0xJeremy/Daedalus/README.md

# Daedalus Motor Controller

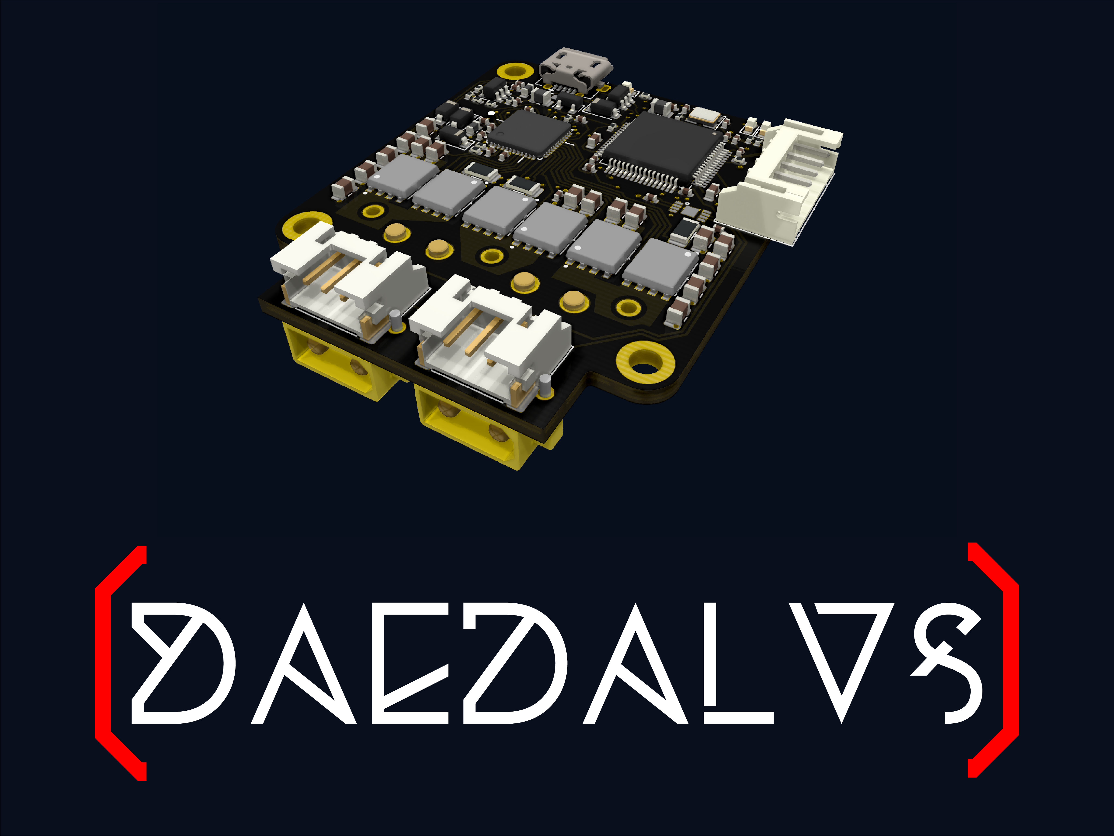
[picture p1: docs/logo/Daedalus_Brackets_Board.png]


### Board Layout
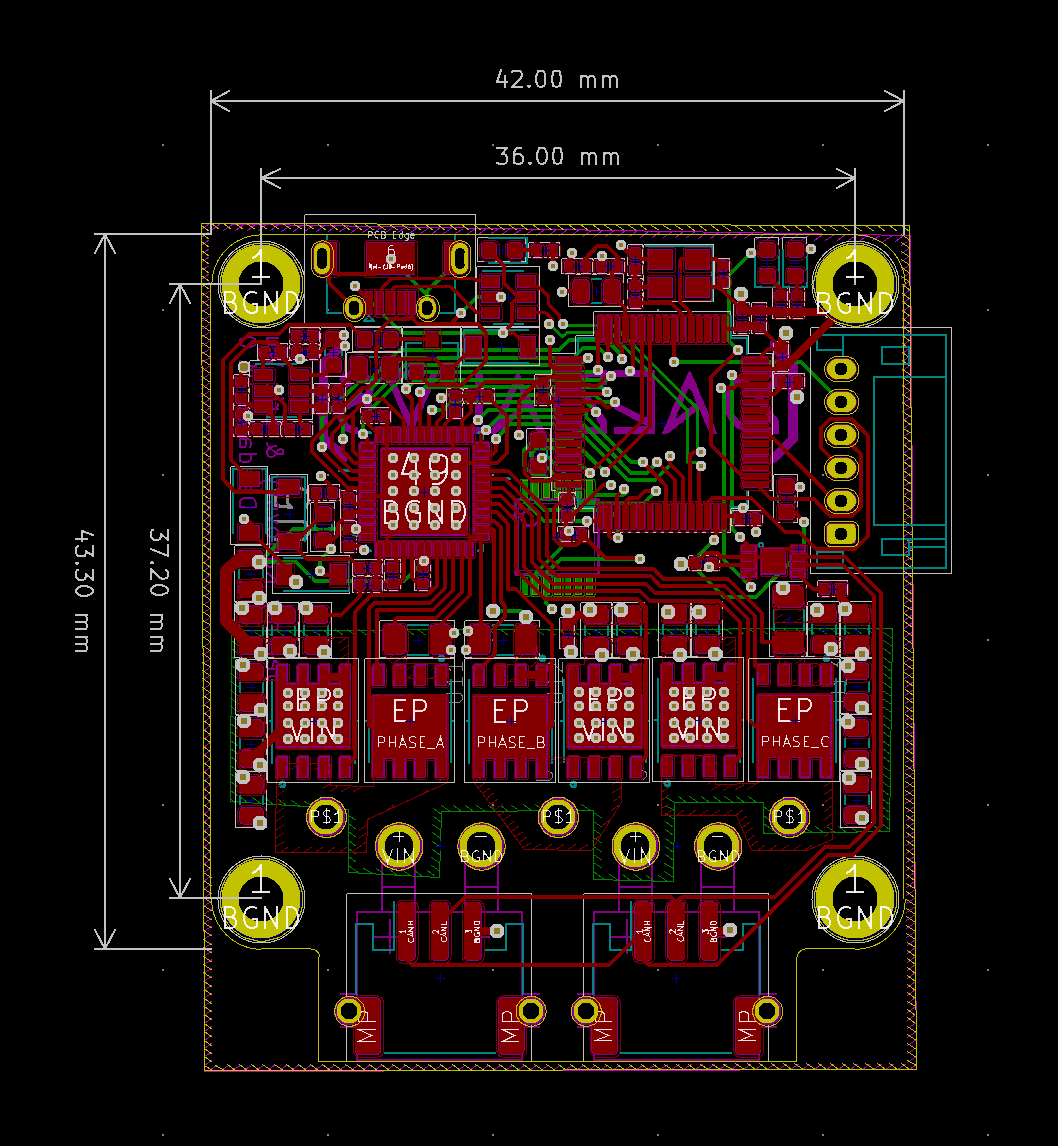
[picture p2: docs/Board_Layout.png]
Board Layout
