0xJeremy/Daedalus/docs/Back.jpg

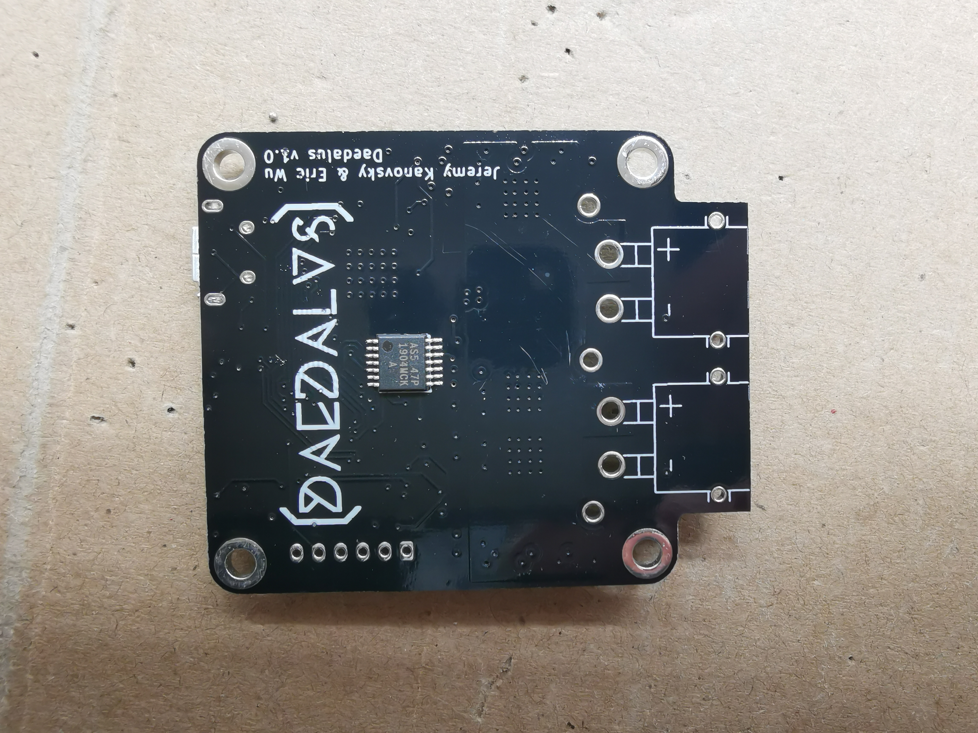
docs/Back.jpg
