0xJeremy/Daedalus/docs/renders/back.png

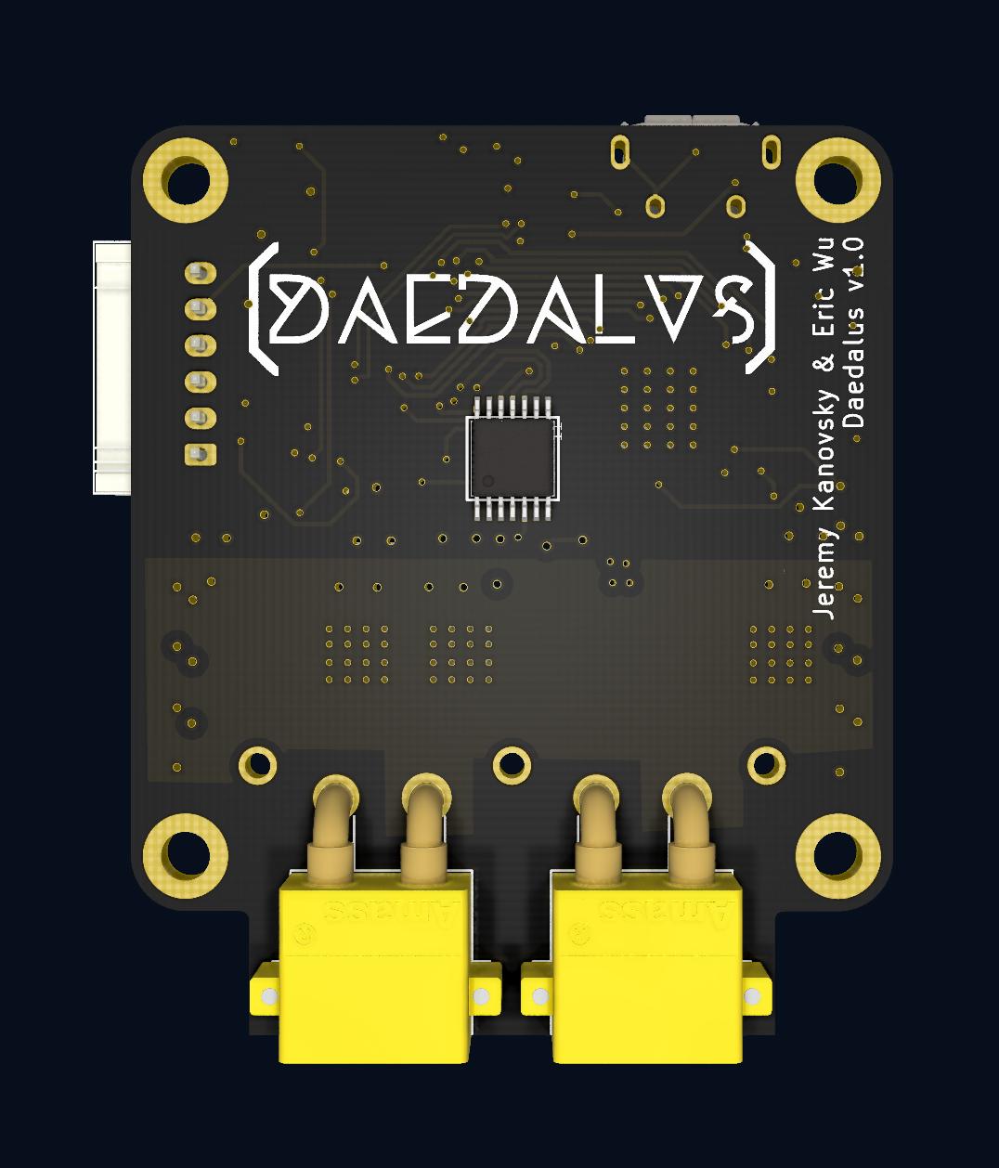
docs/renders/back.png
