0xJeremy/Daedalus/docs/renders/front.png

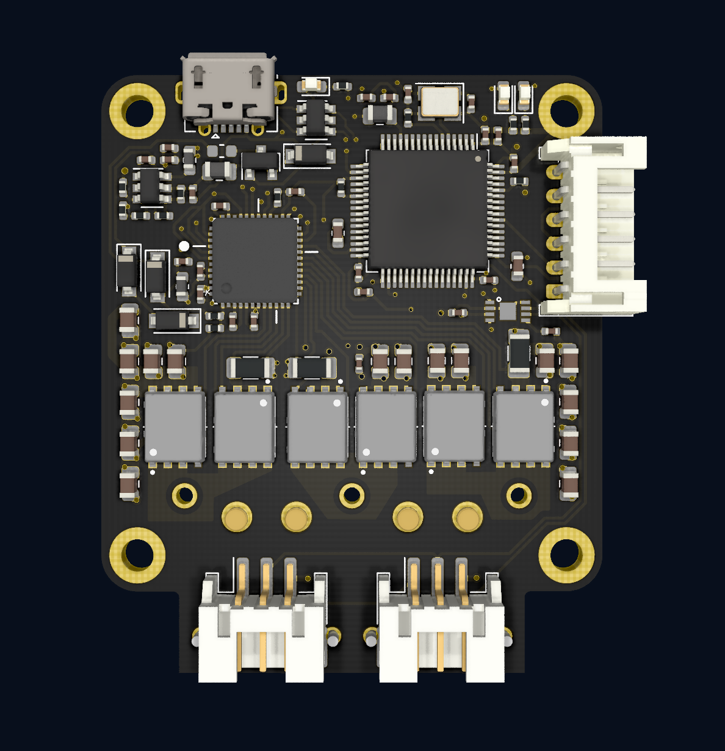
docs/renders/front.png
