0xJeremy/Daedalus/docs/renders/isometric.png

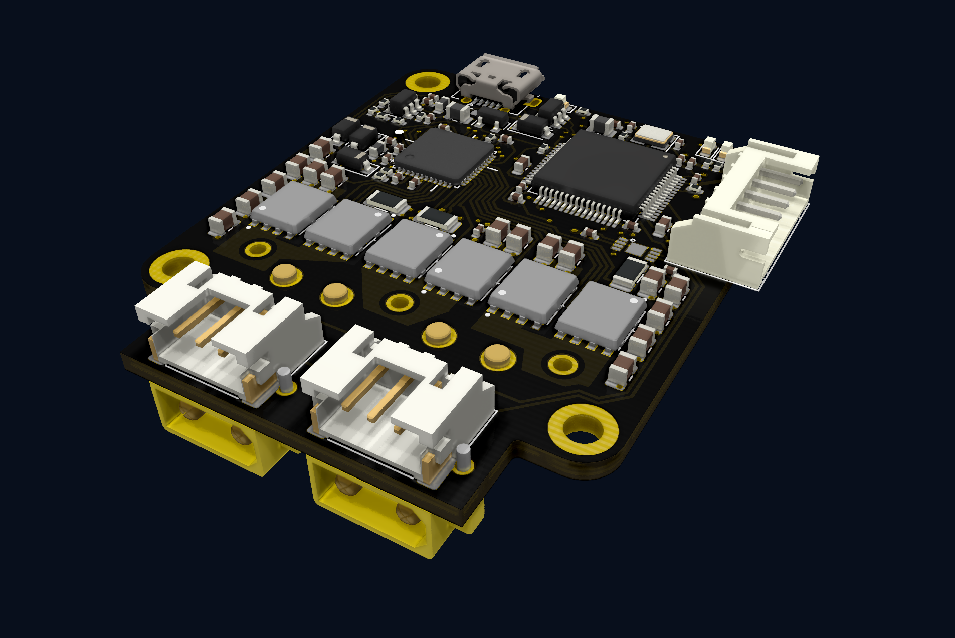
docs/renders/isometric.png
