0xJeremy/Daedalus/docs/renders/side.png

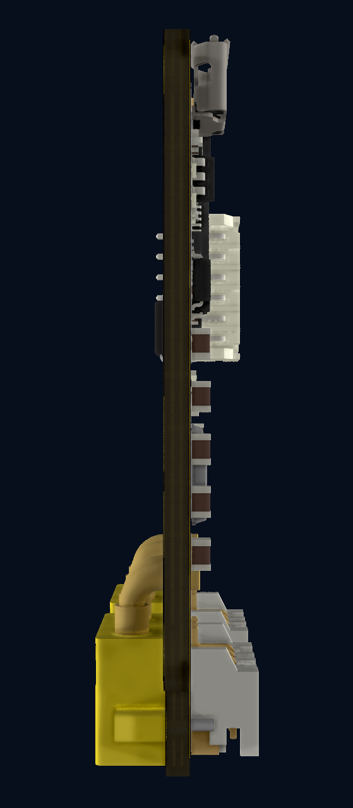
docs/renders/side.png
