0xJeremy/Daedalus/docs/logo/Daedalus Silkscreen.dxf

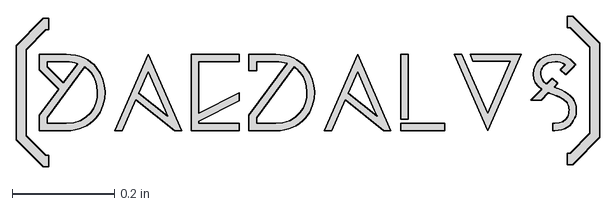
[picture p8: CAD file, 2021-03-04]
docs/logo/Daedalus Silkscreen.dxf
1.14 x 0.294 in
