0xJeremy/Daedalus/docs/Test Stand/Stand.SLDPRT

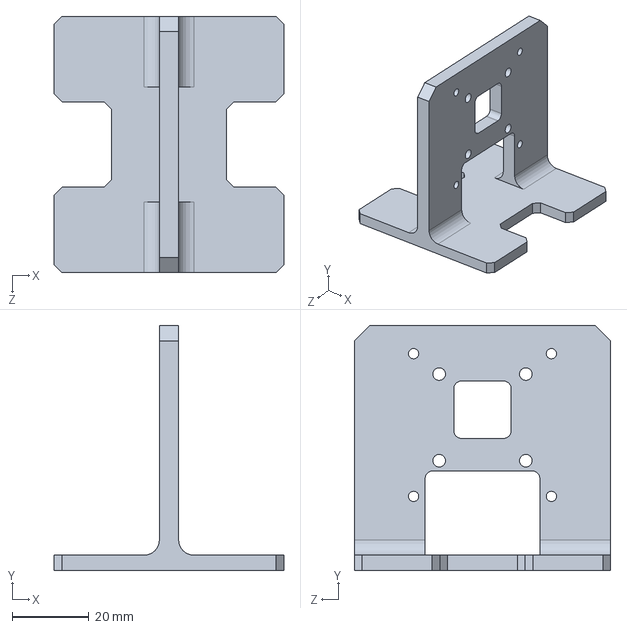
[picture p9: CAD file, 2021-06-15]
docs/Test Stand/Stand.SLDPRT
60.0 x 64.0 x 67.0 mm
