0xJeremy/Daedalus/kicad/daedalus_kicad_lib/STEP/molex_0473460001.STEP

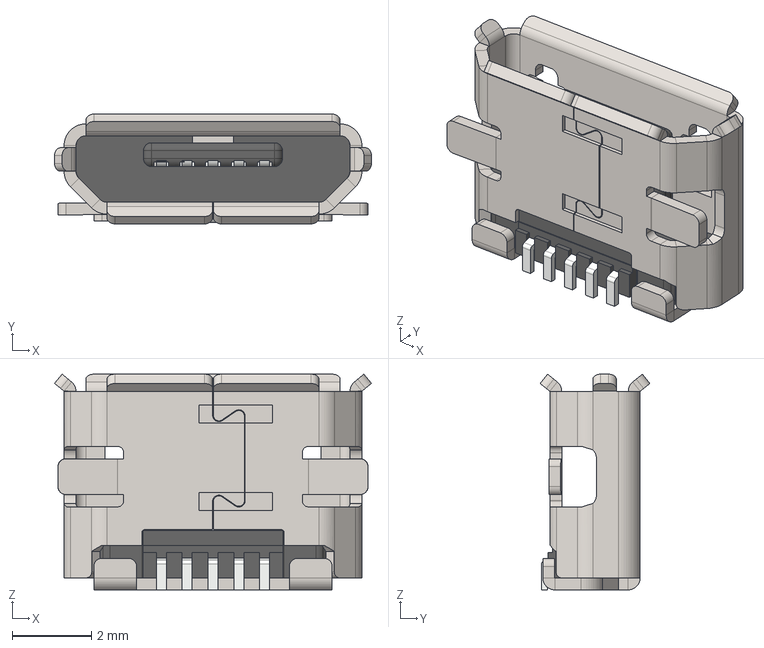
[picture p10: CAD file, 2021-03-02]
kicad/daedalus_kicad_lib/STEP/molex_0473460001.STEP
7.98 x 2.76 x 5.43 mm
