0xJeremy/Daedalus/kicad/daedalus_kicad_lib/STEP/QFN127P600-8N.step

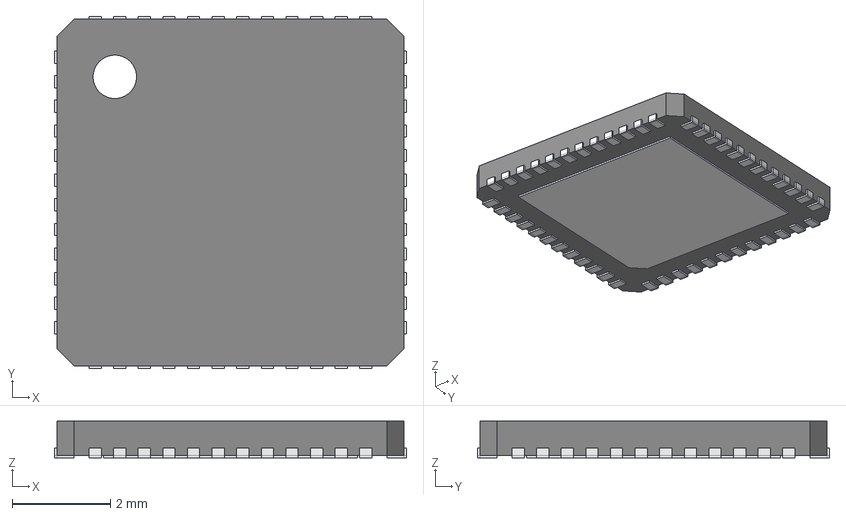
[picture p11: CAD file, 2021-03-02]
kicad/daedalus_kicad_lib/STEP/QFN127P600-8N.step
7.15 x 7.15 x 0.75 mm
Open_CASCADE_STEP_translator_6.8_1.1
Open_CASCADE_STEP_translator_6.8_1.2.1
Thermal_Shape
Open_CASCADE_STEP_translator_6.8_1.4.1 x 48
