0xJeremy/Daedalus/kicad/daedalus_kicad_lib/STEP/TSSOP-14.stp

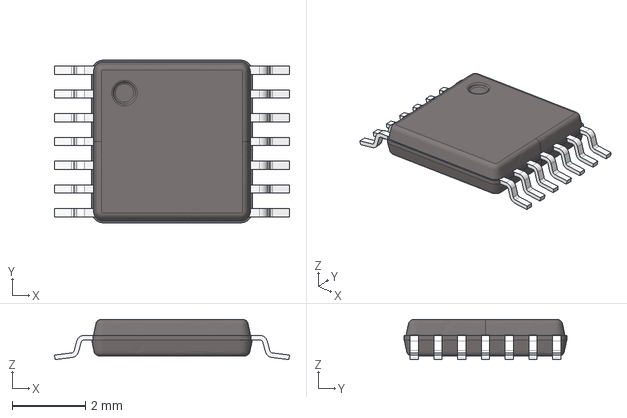
[picture p12: CAD file, 2021-03-02]
kicad/daedalus_kicad_lib/STEP/TSSOP-14.stp
6.43 x 4.45 x 1.10 mm
