0xJeremy/Daedalus/kicad/daedalus_kicad_lib/STEP/Amass_XT30PW-M_pcb solder.stp

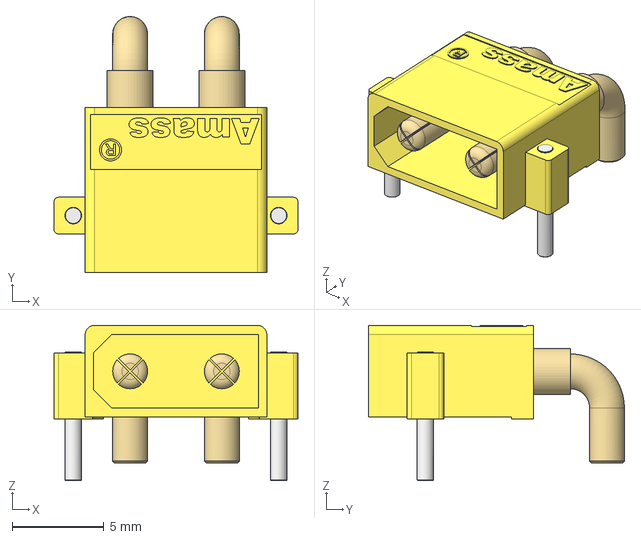
[picture p13: CAD file, 2021-03-02]
kicad/daedalus_kicad_lib/STEP/Amass_XT30PW-M_pcb solder.stp
13.3 x 13.9 x 8.45 mm
