0xJeremy/Daedalus/kicad/daedalus_kicad_lib/STEP/PowerFLAT 5x6.STEP

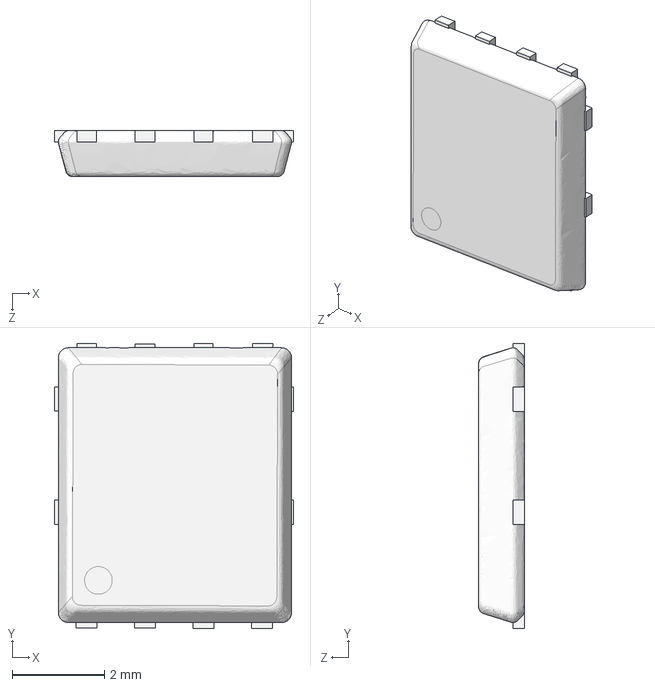
[picture p14: CAD file, 2021-03-02]
kicad/daedalus_kicad_lib/STEP/PowerFLAT 5x6.STEP
5.19 x 6.18 x 1.00 mm
