0xJeremy/Daedalus/kicad/daedalus_kicad_lib/STEP/S3B-PH-SM4-TB.stp

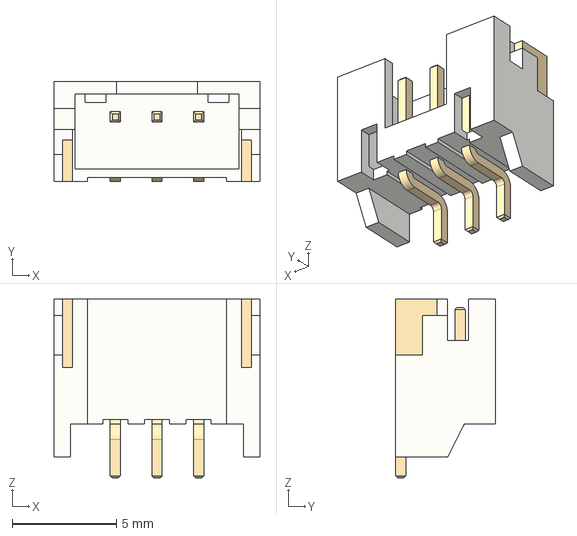
[picture p15: CAD file, 2021-03-02]
kicad/daedalus_kicad_lib/STEP/S3B-PH-SM4-TB.stp
9.90 x 4.80 x 8.60 mm
