0xJeremy/Daedalus/(list of files, cad)

Other CAD files:
docs/Test Stand/exports/Stand.STL
kicad/daedalus_kicad_lib/STEP/PowerFLAT 5x6.stp
