0xJeremy/Daedalus/docs/Test Stand/dependencies/Antigravity 6007 T-Motor/6007_bottom.JPG

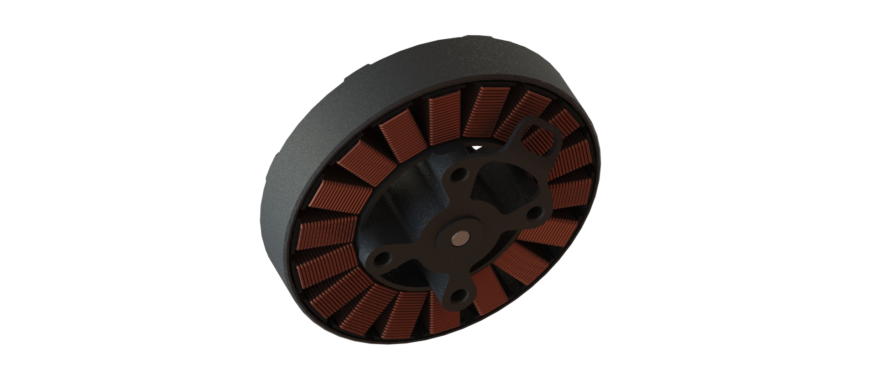
docs/Test Stand/dependencies/Antigravity 6007 T-Motor/6007_bottom.JPG
