0xJeremy/Daedalus/docs/daedalus.pdf

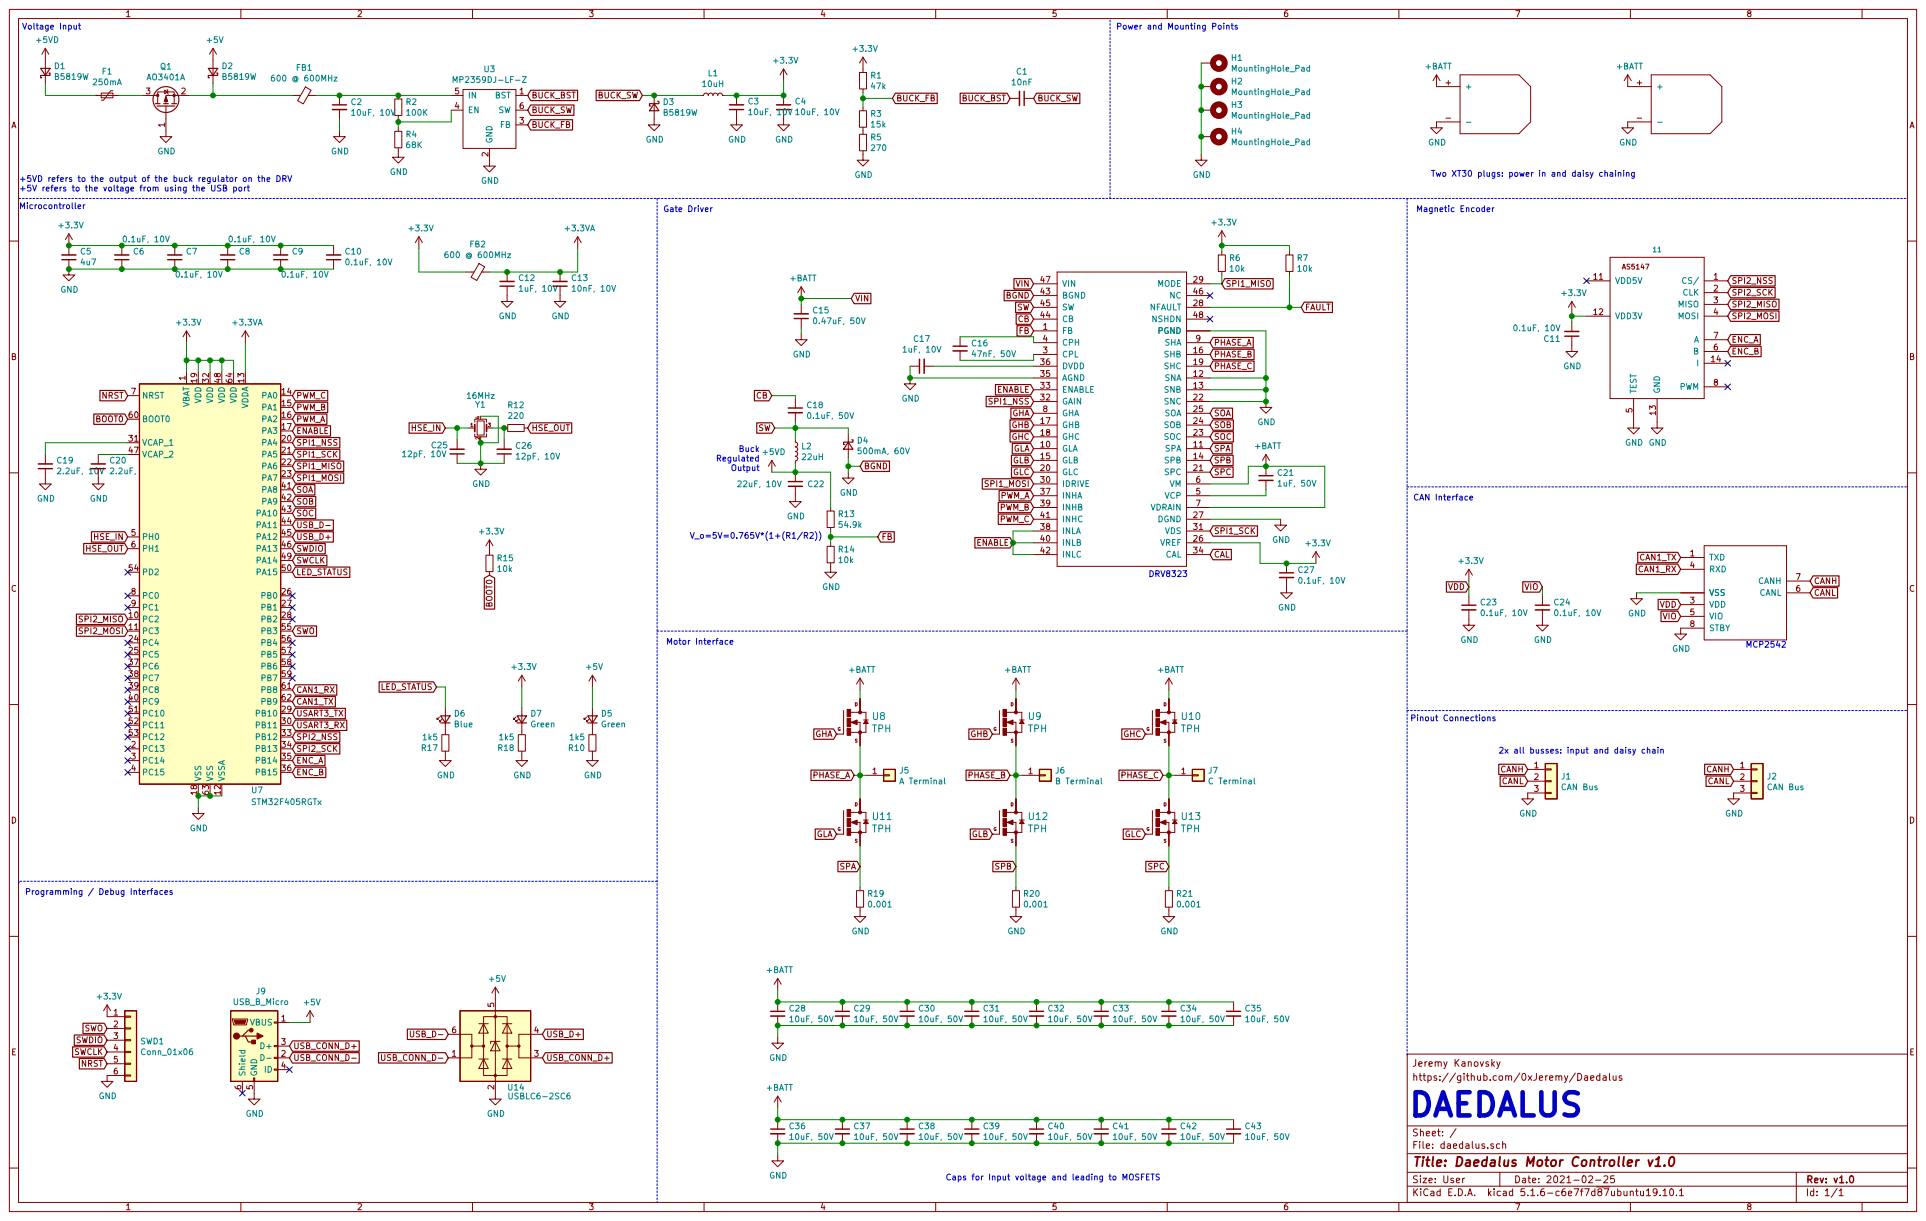
[picture p18: page 1]

Power and Mounting Points Buck Regulated

BUCK_SW
Two XT30 plugs: power in and daisy chaining Pinout Connections

+5VD refers to the output of the buck regulator on the DRV
+5V refers to the voltage from using the USB port

1 VCAP_1 31 VCAP_2 47 VDD 19 VDD 32 VDD 48 VDD 64 VDDA 13 VSS 18 VSS 63 VSSA 12U7STM32F405RGTx

2x all busses: input and daisy chain

Jeremy Kanovsky
File: daedalus.sch Sheet: / https://github.com/0xJeremy/Daedalus
DAEDALUS

Id: 1/1 Title: Daedalus Motor Controller v1.0

Caps for Input voltage and leading to MOSFETS
