0xJeremy/Daedalus/kicad/daedalus.kicad_pcb

## KiCad design kicad/daedalus.kicad_pcb (2021-03-08)

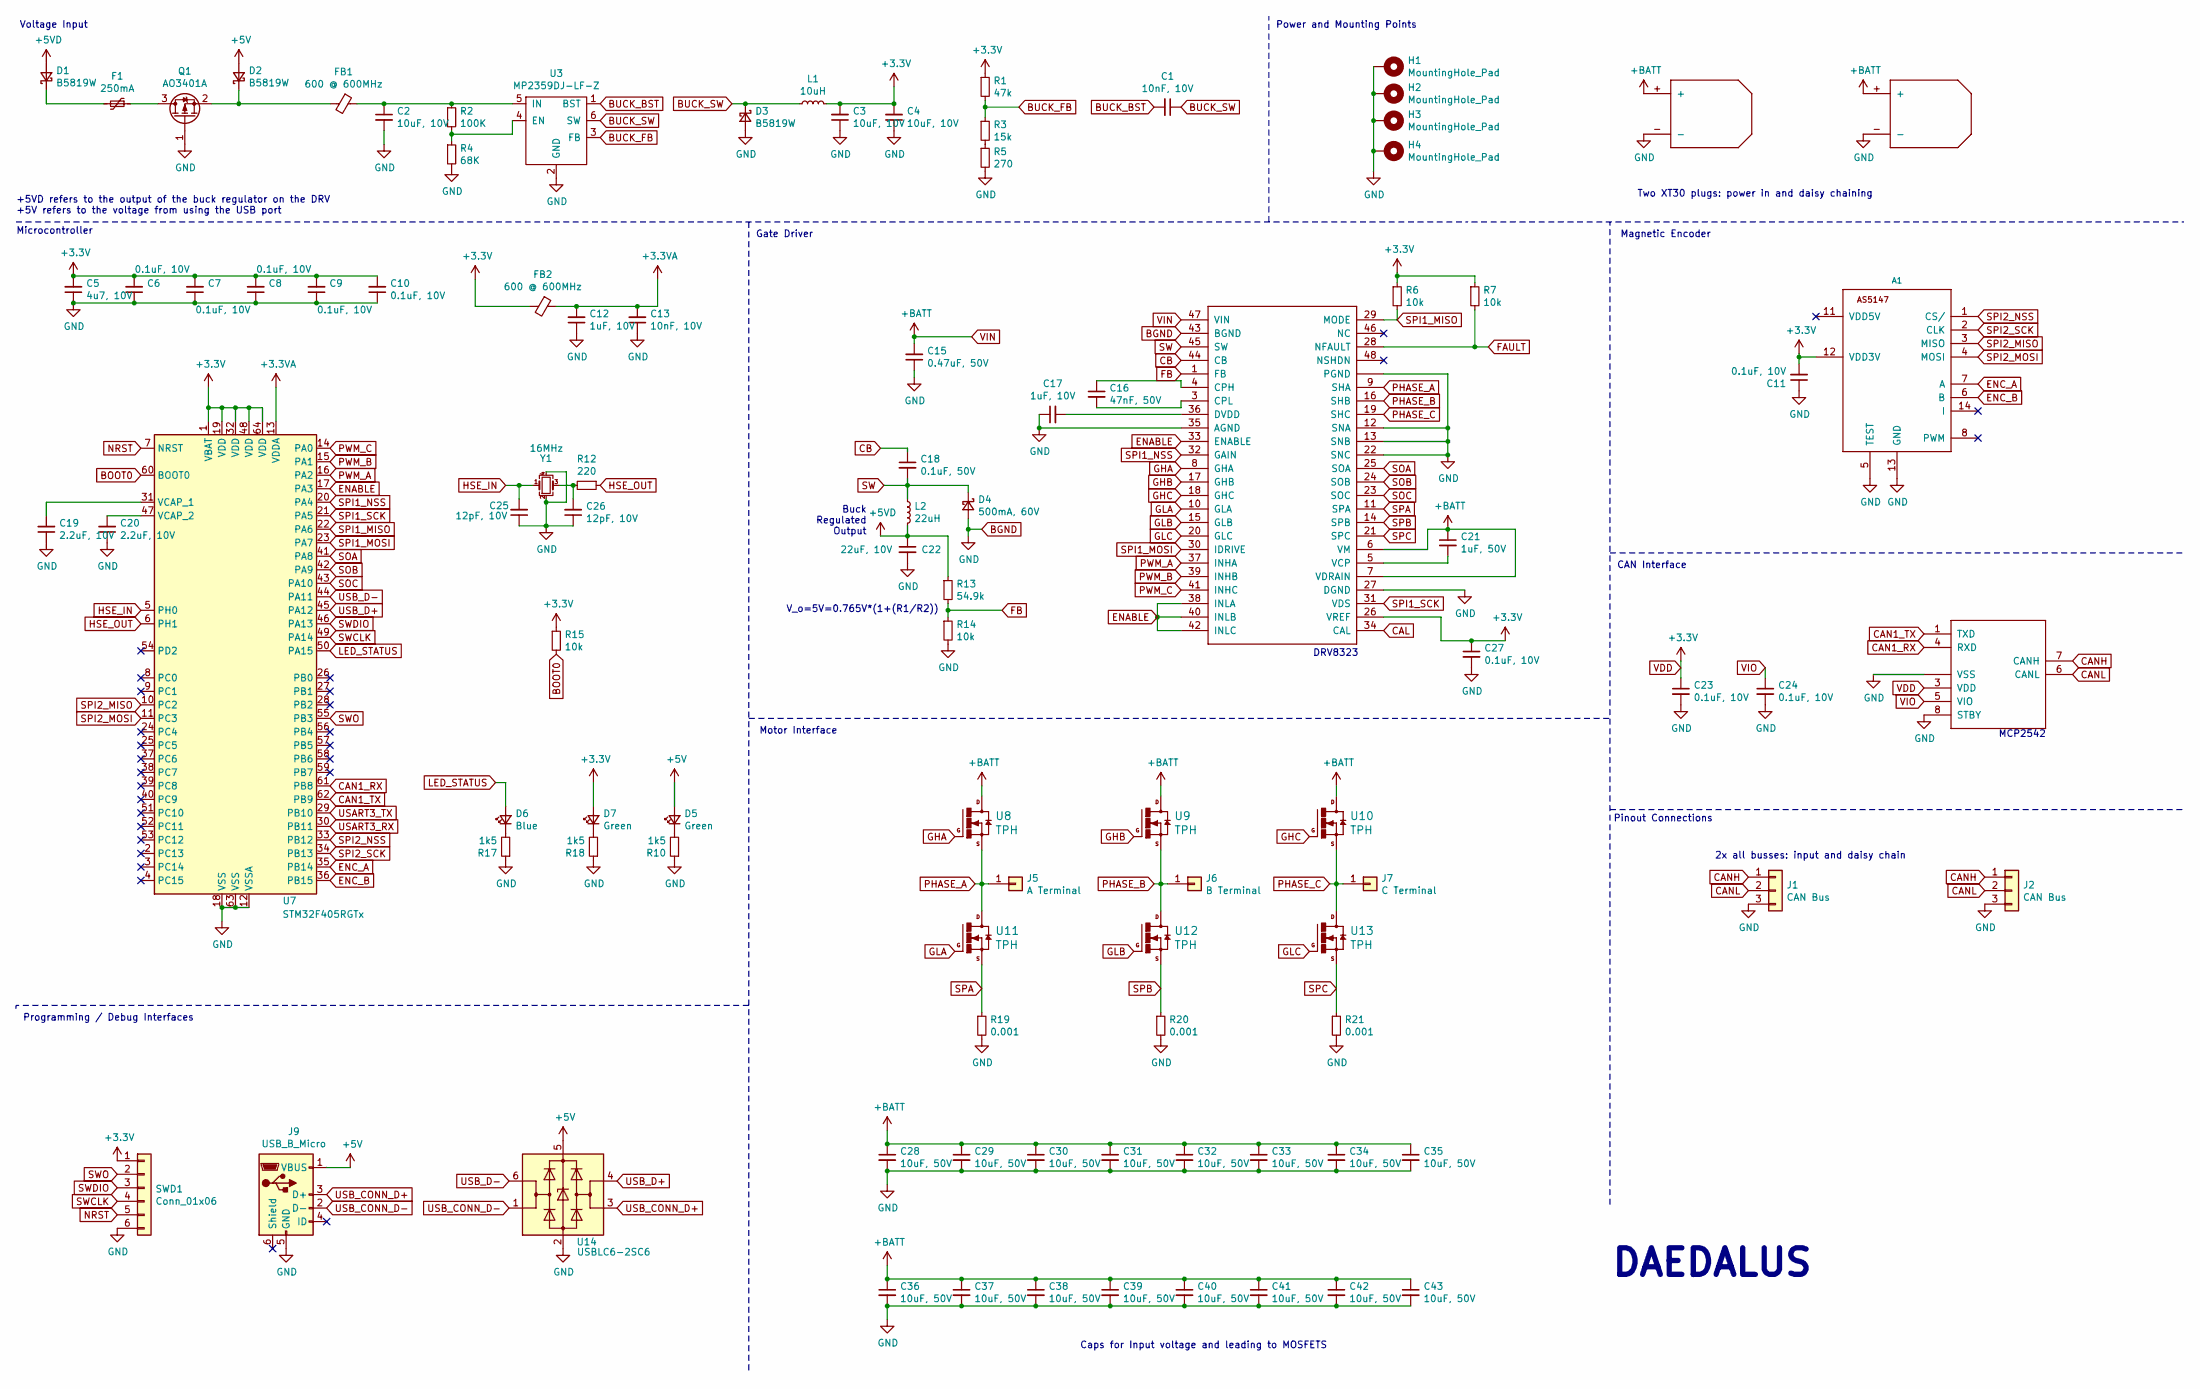
[picture p19: schematic daedalus.sch, Daedalus Motor Controller v1.0]

Parts:
A1: AS5147; TSSOP14_as5147
C1: 10nF, 10V; C_0402_1005Metric
C2, C3, C4: 10uF, 10V; C_0402_1005Metric
C5: 4u7, 10V; C_0402_1005Metric; LCSC Part # C23733
C6, C7, C8, C9, C10: 0.1uF, 10V; C_0402_1005Metric; LCSC Part # C1525
C11, C23, C24, C27: 0.1uF, 10V; C_0402_1005Metric
C12: 1uF, 10V; C_0402_1005Metric; LCSC Part # C1525
C13: 10nF, 10V; C_0402_1005Metric; LCSC Part # C1523
C15: 0.47uF, 50V; C_0402_1005Metric
C16: 47nF, 50V; C_0402_1005Metric
C17: 1uF, 10V; C_0402_1005Metric
C18: 0.1uF, 50V; C_0402_1005Metric
C19, C20: 2.2uF, 10V; C_0603_1608Metric; LCSC Part # C23630
C21: 1uF, 50V; C_0402_1005Metric
C22: 22uF, 10V; C_0402_1005Metric
C25, C26: 12pF, 10V; C_0402_1005Metric; LCSC Part # C1547
C28, C29, C30, C31, C32, C33, C34, C35, C36, C37, C38, C39, C40, C41, C42, C43: 10uF, 50V; C_0805_2012Metric
D1, D2, D3: B5819W; D_SOD-123
D4: 500mA, 60V; D_SOD-123
D5, D7: Green; LED_0603_1608Metric; LCSC Part # C2286
D6: Blue; LED_0603_1608Metric; LCSC Part # C2286
F1: 250mA; Fuse_0603_1608Metric
FB1: 600 @ 600MHz; L_0805_2012Metric
FB2: 600 @ 600MHz; L_0805_2012Metric; LCSC Part # C1015
H1, H2, H3, H4: MountingHole_Pad; MountingHole_2.7mm_M2.5_DIN965_Pad
J1, J2: CAN Bus; JST_PH_S3B-PH-SM4-TB_1x03-1MP_P2.00mm_Horizontal
J5: A Terminal; 18_AWG_PAD
J6: B Terminal; 18_AWG_PAD
J7: C Terminal; 18_AWG_PAD
J9: USB_B_Micro; USB_Micro-AB_Molex_47590-0001
L1: 10uH; L_0603_1608Metric
L2: 22uH; L_0603_1608Metric
Q1: AO3401A; SOT-23
R1: 47k; R_0402_1005Metric
R2: 100K; R_0402_1005Metric
R3: 15k; R_0402_1005Metric
R4: 68K; R_0402_1005Metric
R5: 270; R_0402_1005Metric
R6, R7, R14: 10k; R_0402_1005Metric
R10, R17, R18: 1k5; R_0402_1005Metric; LCSC Part # C25867
R12: 220; R_0402_1005Metric; LCSC Part # C22962
R13: 54.9k; R_0402_1005Metric
R15: 10k; R_0402_1005Metric; LCSC Part # C25744
R19, R20, R21: 0.001; R_1206_3216Metric
SWD1: Conn_01x06; JST_PH_S6B-PH-K_1x06_P2.00mm_Horizontal
U1, U2: XT30; XT30_HORIZONTAL
U3: MP2359DJ-LF-Z; SOT-23-6
U5: DRV8323RH; QFN50P700X700X90-49N
U6: MCP2542; TDFN
U7: STM32F405RGTx; LQFP-64_10x10mm_P0.5mm; LCSC Part # C15742
U8, U9, U10, U11, U12, U13: TPH; TRANS_TPH5900CNH,L1Q
U14: USBLC6-2SC6; SOT-23-6
Y1: 16MHz; Crystal_SMD_3225-4Pin_3.2x2.5mm; LCSC Part # C13738

Connections:
+3.3VA: C12.2, C13.2, FB2.1, U7.13 (VDDA)
+5V: D2.2 (A), D5.2 (A), J9.1 (VBUS), U14.5 (VBUS)
+5VD: C22.1, D1.2 (A), L2.2, R13.1
BGND: A1.5 (TEST), A1.13 (GND), C2.2, C3.1, C4.1, C5.1, C6.1, C7.1, C8.1, C9.1, C10.1, C11.1, C12.1, C13.1, C15.1, C17.1, C19.1, C20.1, C22.2, C23.2, C24.2, C25.1, C26.1, C27.2, C28.2, C29.2, C30.2, C31.2, C32.2, C33.2, C34.2, C35.2, C36.2, C37.2, C38.2, C39.2, C40.2, C41.2, C42.2, C43.2, D3.2 (A), D4.2 (A), H1.1, H2.1, H3.1, H4.1, J1.3, J2.3, J9.5 (GND), Q1.1 (G), R4.2, R5.2, R10.1, R14.2, R17.1, R18.1, R19.2, R20.2, R21.2, SWD1.6, U1.-, U2.-, U3.2 (GND), U5.2 (PGND), U5.12 (SNA), U5.13 (SNB), U5.22 (SNC), U5.27 (DGND), U5.35 (AGND), U5.43 (BGND), U5.49 (PGND), U6.2 (VSS), U6.8 (STBY), U6.9 (VSS), U7.12 (VSSA), U7.18 (VSS), U7.63 (VSS), U14.2 (GND), Y1.2, Y1.4
BOOT0: R15.2, U7.60 (BOOT0)
BUCK_BST: C1.2, U3.1 (BST)
BUCK_FB: R1.2, R3.1, U3.3 (FB)
BUCK_SW: C1.1, D3.1 (K), L1.1, U3.6 (SW)
CAL: U5.34 (CAL)
CAN1_RX: U6.4 (RXD), U7.61 (PB8)
CAN1_TX: U6.1 (TXD), U7.62 (PB9)
CANH: J1.1, J2.1, U6.7 (CANH)
CANL: J1.2, J2.2, U6.6 (CANL)
CB: C18.1, U5.44 (CB)
ENABLE: U5.33 (ENABLE), U5.38 (INLA), U5.40 (INLB), U5.42 (INLC), U7.17 (PA3)
ENC_A: A1.7 (A), U7.35 (PB14)
ENC_B: A1.6 (B), U7.36 (PB15)
FAULT: R7.2, U5.28 (NFAULT)
FB: R13.2, R14.1, U5.1 (FB)
GHA: U5.8 (GHA), U8.4 (G)
GHB: U5.17 (GHB), U9.4 (G)
GHC: U5.18 (GHC), U10.4 (G)
GLA: U5.10 (GLA), U11.4 (G)
GLB: U5.15 (GLB), U12.4 (G)
GLC: U5.20 (GLC), U13.4 (G)
HSE_IN: C25.2, U7.5 (PH0), Y1.1
HSE_OUT: R12.1, U7.6 (PH1)
LED_STATUS: D6.2 (A), U7.50 (PA15)
NRST: SWD1.5, U7.7 (NRST)
unnamed: C2.1, FB1.1, R2.1, U3.5 (IN)
unnamed: C16.1, U5.4 (CPH)
unnamed: C16.2, U5.3 (CPL)
unnamed: C17.2, U5.36 (DVDD)
unnamed: C19.2, U7.31 (VCAP_1)
unnamed: C20.2, U7.47 (VCAP_2)
unnamed: C21.2, U5.5 (VCP)
unnamed: C26.2, R12.2, Y1.3
unnamed: D1.1 (K), F1.2
unnamed: D2.1 (K), FB1.2, Q1.2 (S)
unnamed: D5.1 (K), R10.2
unnamed: D6.1 (K), R17.2
unnamed: D7.1 (K), R18.2
unnamed: F1.1, Q1.3 (D)
unnamed: R2.2, R4.1, U3.4 (EN)
unnamed: R3.2, R5.1
PHASE_A: J5.1, U5.9 (SHA), U8.1 (S), U8.2 (S), U8.3 (S), U11.5 (D), U11.6 (D), U11.7 (D), U11.8 (D), U11.EP (D)
PHASE_B: J6.1, U5.16 (SHB), U9.1 (S), U9.2 (S), U9.3 (S), U12.5 (D), U12.6 (D), U12.7 (D), U12.8 (D), U12.EP (D)
PHASE_C: J7.1, U5.19 (SHC), U10.1 (S), U10.2 (S), U10.3 (S), U13.5 (D), U13.6 (D), U13.7 (D), U13.8 (D), U13.EP (D)
PWM_A: U5.37 (INHA), U7.16 (PA2)
PWM_B: U5.39 (INHB), U7.15 (PA1)
PWM_C: U5.41 (INHC), U7.14 (PA0)
SOA: U5.25 (SOA), U7.41 (PA8)
SOB: U5.24 (SOB), U7.42 (PA9)
SOC: U5.23 (SOC), U7.43 (PA10)
SPA: R19.1, U5.11 (SPA), U11.1 (S), U11.2 (S), U11.3 (S)
SPB: R20.1, U5.14 (SPB), U12.1 (S), U12.2 (S), U12.3 (S)
SPC: R21.1, U5.21 (SPC), U13.1 (S), U13.2 (S), U13.3 (S)
SPI1_MISO: R6.2, U5.29 (MODE), U7.22 (PA6)
SPI1_MOSI: U5.30 (IDRIVE), U7.23 (PA7)
SPI1_NSS: U5.32 (GAIN), U7.20 (PA4)
SPI1_SCK: U5.31 (VDS), U7.21 (PA5)
SPI2_MISO: A1.3 (MISO), U7.10 (PC2)
SPI2_MOSI: A1.4 (MOSI), U7.11 (PC3)
SPI2_NSS: A1.1 (CS/), U7.33 (PB12)
SPI2_SCK: A1.2 (CLK), U7.34 (PB13)
SW: C18.2, D4.1 (K), L2.1, U5.45 (SW)
SWCLK: SWD1.4, U7.49 (PA14)
SWDIO: SWD1.3, U7.46 (PA13)
SWO: SWD1.2, U7.55 (PB3)
USART3_RX: U7.30 (PB11)
USART3_TX: U7.29 (PB10)
USB_CONN_D+: J9.3 (D+), U14.3 (I/O2)
USB_CONN_D-: J9.2 (D-), U14.1 (I/O1)
USB_D+: U7.45 (PA12), U14.4 (I/O2)
USB_D-: U7.44 (PA11), U14.6 (I/O1)
VDD: A1.12 (VDD3V), C3.2, C4.2, C5.2, C6.2, C7.2, C8.2, C9.2, C10.2, C11.2, C23.1, C27.1, D7.2 (A), FB2.2, L1.2, R1.1, R6.1, R7.1, R15.1, SWD1.1, U5.26 (VREF), U6.3 (VDD), U7.1 (VBAT), U7.19 (VDD), U7.32 (VDD), U7.48 (VDD), U7.64 (VDD)
VIN: C15.2, C21.1, C28.1, C29.1, C30.1, C31.1, C32.1, C33.1, C34.1, C35.1, C36.1, C37.1, C38.1, C39.1, C40.1, C41.1, C42.1, C43.1, U1.+, U2.+, U5.6 (VM), U5.7 (VDRAIN), U5.47 (VIN), U8.5 (D), U8.6 (D), U8.7 (D), U8.8 (D), U8.EP (D), U9.5 (D), U9.6 (D), U9.7 (D), U9.8 (D), U9.EP (D), U10.5 (D), U10.6 (D), U10.7 (D), U10.8 (D), U10.EP (D)
VIO: C24.1, U6.5 (VIO)

Notes on the sheet:
Microcontroller
Voltage Input
Programming / Debug Interfaces
Power and Mounting Points
Gate Driver
Magnetic Encoder
DRV8323
Motor Interface
CAN Interface
MCP2542
Pinout Connections
V_o=5V=0.765V*(1+(R1/R2))
Buck Regulated Output
+5VD refers to the output of the buck regulator on the DRV +5V refers to the voltage from using the USB port
Two XT30 plugs: power in and daisy chaining
2x all busses: input and daisy chain
Caps for Input voltage and leading to MOSFETS
DAEDALUS

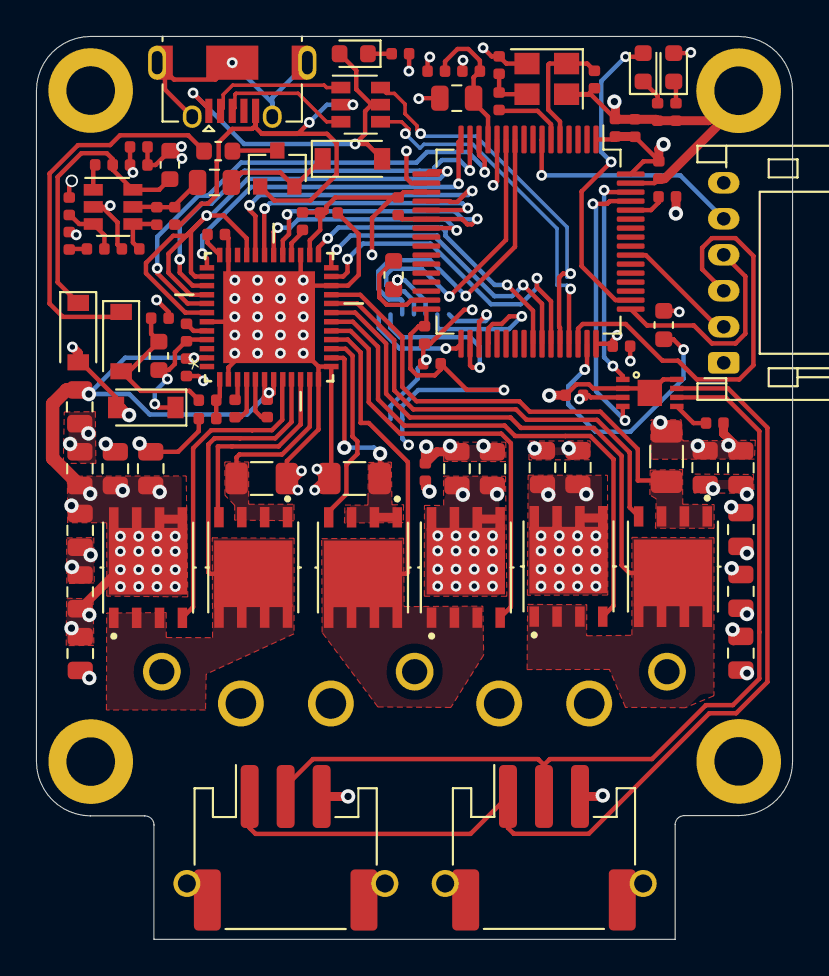
[picture p20: board daedalus.kicad_pcb from above]

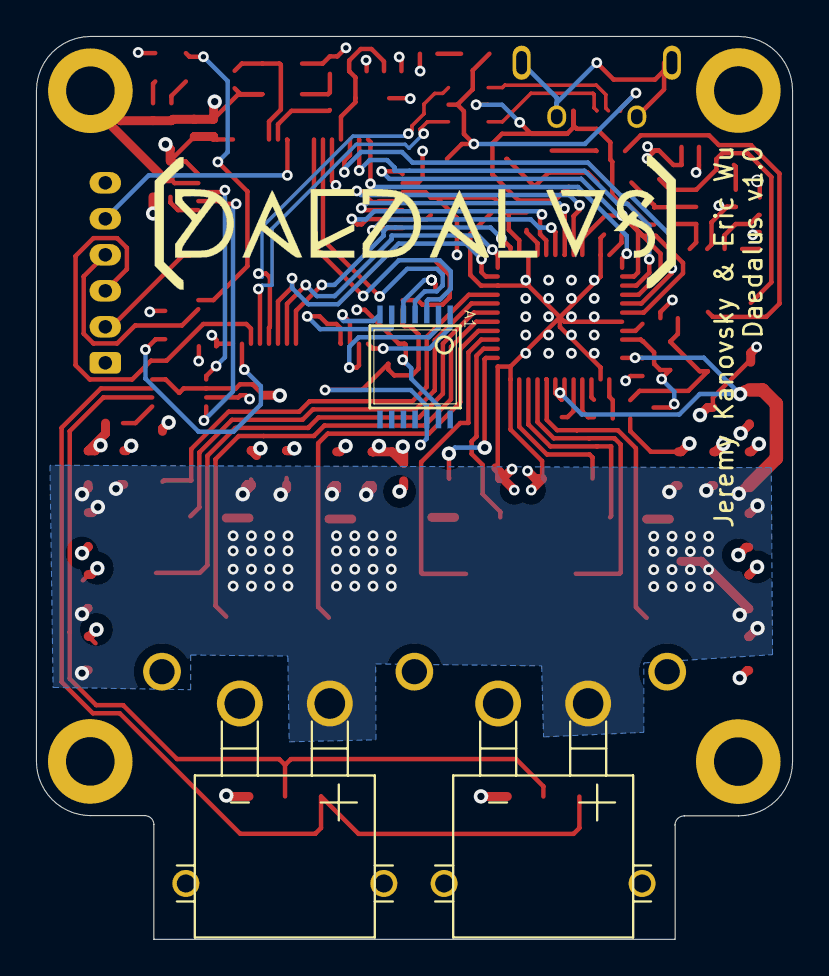
[picture p21: board daedalus.kicad_pcb from below]

Board: 4 copper layers, 42.0 x 50.2 mm, 98 parts (3 on the bottom side), 75 nets.
