0xJeremy/Daedalus/Daedalus CubeMX Project Files/Daedalus CubeMX Project Files.ioc

PH0-OSC_IN.Signal=RCC_OSC_IN
Mcu.UserName=STM32F405RGTx
PB11.Signal=USART3_RX
PB13.Signal=SPI2_SCK
PA12.Signal=USB_OTG_FS_DP
PB6.Signal=I2C1_SCL
PC3.Signal=SPI2_MOSI
PB7.Signal=I2C1_SDA
PB9.Signal=CAN1_TX
PA6.Signal=SPI1_MISO
PA15.Signal=GPIO_Output
PB4.Signal=GPIO_Output
PC2.Signal=SPI2_MISO
PA0-WKUP.Signal=GPIO_Output
PA13.Signal=SYS_JTMS-SWDIO
PA1.Signal=GPIO_Output
PB10.Signal=USART3_TX
PA5.Signal=SPI1_SCK
PH1-OSC_OUT.Signal=RCC_OSC_OUT
PA2.Signal=GPIO_Output
PB3.Signal=SYS_JTDO-SWO
PA4.Signal=SPI1_NSS
PA11.Signal=USB_OTG_FS_DM
PA14.Signal=SYS_JTCK-SWCLK
PB8.Signal=CAN1_RX
PB0.Signal=GPIO_Output
PB12.Signal=SPI2_NSS
PA7.Signal=SPI1_MOSI
