0xJeremy/Daedalus/(commit log)

2021-02-13 Added initial schematic
    [daedalus.kicad_pcb, daedalus.sch]
2021-02-13 Updated schematic with MPU6050
    [daedalus.sch]
2021-02-14 Added footprints and side headers
    [daedalus.kicad_pcb, daedalus.sch]
2021-02-22 Began work adding DRV8323
    [daedalus.sch]
2021-02-22 Added SPI busses, updated CubeMX files
    [daedalus.sch]
2021-02-23 Added CAN interface, fixed value labels
    [daedalus.sch]
2021-02-23 Updated buck regulator output, removed battery connector
    [daedalus.sch]
2021-02-24 Updated schematic, added footprints, added BOM
    [daedalus.sch]
2021-02-24 Began board layout
    [daedalus.kicad_pcb, daedalus.sch]
2021-02-25 Began sample routing, removed boot switch
    [daedalus.kicad_pcb, daedalus.sch]
2021-02-25 Updated footprint and routing
    [daedalus.kicad_pcb, daedalus.sch]
2021-02-28 Updated schematic, began v3 layout
    [daedalus.kicad_pcb, daedalus.sch]
2021-02-28 Finished rough layout v3
    [daedalus.kicad_pcb]
2021-02-28 Added 5V LED, finished standard routes; about to start pours
    [daedalus.kicad_pcb, daedalus.sch]
2021-02-28 Finished v3 board layout; needs fill cleanup
    [daedalus.kicad_pcb]
2021-03-01 Fixed design rules, fixed pours
    [daedalus.kicad_pcb]
2021-03-02 updated step files
    [Amass_XT30PW-M_pcb solder.stp, PowerFLAT 5x6.STEP, PowerFLAT 5x6.stp, QFN127P600-8N.step, S3B-PH-SM4-TB.stp, TSSOP-14.stp, molex_0473460001.STEP]
2021-03-02 fixing xt30
    [daedalus.kicad_pcb]
2021-03-02 Added board renders, updated board schematic
2021-03-02 Added initial BOM
    [daedalus_bom.csv]
2021-03-02 Finished preliminary BOM
    [daedalus.kicad_pcb, daedalus.sch, daedalus_bom.csv]
2021-03-04 Updated vias, added vias, removed i2c line and pullups, added renders
    [daedalus.kicad_pcb, daedalus.sch]
2021-03-04 Updated file structure, added new BOM
    [Amass_XT30PW-M_pcb solder.stp, PowerFLAT 5x6.STEP, PowerFLAT 5x6.stp, QFN127P600-8N.step, S3B-PH-SM4-TB.stp, TSSOP-14.stp, daedalus.kicad_pcb, daedalus.sch]
2021-03-04 Removed outdated files
    [Amass_XT30PW-M_pcb solder.stp, PowerFLAT 5x6.STEP, PowerFLAT 5x6.stp, QFN127P600-8N.step, S3B-PH-SM4-TB.stp, TSSOP-14.stp, daedalus.kicad_pcb, daedalus.sch]
2021-03-04 Added BOM
    [daedalus_bom.xlsx]
2021-03-04 Added PCBWay Pitch
2021-03-04 Updated logo with render, added silkscreen bmp
    [Daedalus Silkscreen.dxf]
2021-03-04 Update Pitch.md
    OrbitActuator -> OrbitDrive :)
2021-03-05 Added gerber files and centroid file
    [daedalus-B_Cu.gbr, daedalus-B_Mask.gbr, daedalus-B_Paste.gbr, daedalus-B_SilkS.gbr, daedalus-Edge_Cuts.gbr, daedalus-F_Cu.gbr, daedalus-F_Mask.gbr, daedalus-F_Paste.gbr]
2021-03-08 Updated gerber file for manufacturing
    [daedalus-B_Cu.gbr, daedalus-B_Mask.gbr, daedalus-B_Paste.gbr, daedalus-B_SilkS.gbr, daedalus-Edge_Cuts.gbr, daedalus-F_Cu.gbr, daedalus-F_Mask.gbr, daedalus-F_Paste.gbr]
2021-06-15 Added test stand model
    [Stand.SLDPRT, Stand.STL]
